ittipu/xiao-esp32-s3-wifi-ethernet-failover/xiao_s3_wifi_eth_failover/secrets.example.h

// Copy this file to secrets.h and fill in your WiFi details.
// secrets.h is git-ignored, so your password never ends up on GitHub.
#pragma once
#define WIFI_SSID_SECRET "YOUR_WIFI_NAME"
#define WIFI_PASS_SECRET "YOUR_WIFI_PASSWORD"
