ittipu/xiao-esp32-s3-wifi-ethernet-failover/(commit log)

2026-10-17 WiFi + Ethernet failover IoT node with live dashboard
    XIAO ESP32-S3 PoE firmware: Ethernet main / WiFi backup failover over one
    MQTT connection, DHT22 + TSL2561 sensors, SH1106 OLED. Flask + Socket.IO +
    SQLite dashboard with link timeline, sensor charts and failover log.
    [secrets.example.h, xiao_s3_wifi_eth_failover.ino]
2026-10-17 Add wiring diagram; ignore TSL2561 saturation readings
    - docs/wiring-diagram.svg: board, DHT22, TSL2561, OLED, power rails, legend;
    shown in the README pin map and WIRING.md
    - firmware 1.3.2: the TSL2561 driver returns 65536 lux when saturated;
    send null instead of a fake value
2026-10-17 Add live dashboard screenshots to the README
    - docs/dashboard.jpg: full 1920x1080 dashboard (WiFi down, still on
    Ethernet, timeline of switches) shown at the top of the README
    - docs/timeline.jpg: close-up of the live sensor timeline in The demo
2026-10-17 README: add photo of an OLED on the wrong driver
    Shows the SH1106-as-SSD1306 symptoms (clipped left edge, garbage column)
    next to the OLED_SH1106 fix, linked from troubleshooting.
2026-10-19 Remove placeholder link for XIAO ESP32-S3 PoE
    Removed placeholder link for XIAO ESP32-S3 PoE in README.
